soggybag/Wave-Folder/Wavefolder Yusynth - wiring.jpg

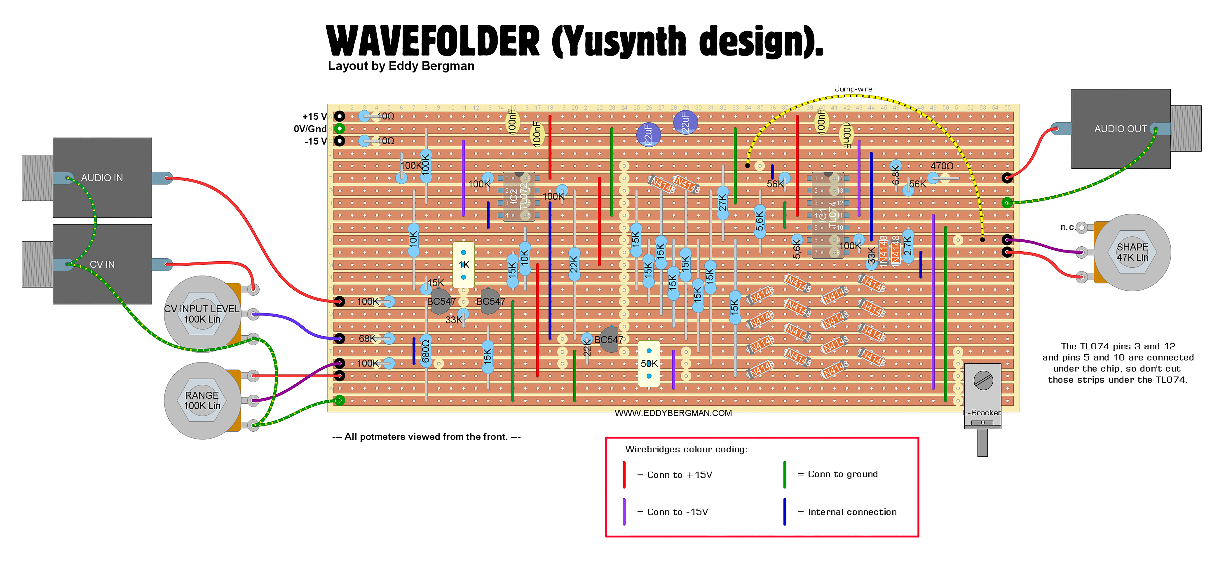
Wavefolder Yusynth - wiring.jpg
