soggybag/Wave-Folder/README.md

# Wave Folder (Eurorack 4HP)

YuSynth wavefolder reworked as a 4HP Eurorack module: BAV99 pairs, matched NPN VCA, split boards. KiCad project in `Wave_Folder/`, panel in `Front-Panel/`.

**Status:** PCB and fab files done; not ordered. YuSynth designs are shared for DIY use: ask before selling.

Product notes and ratings: `../Product Notes.md`, `../Project Status.xlsx`.
