soggybag/Wave-Folder/Wave Folder.png

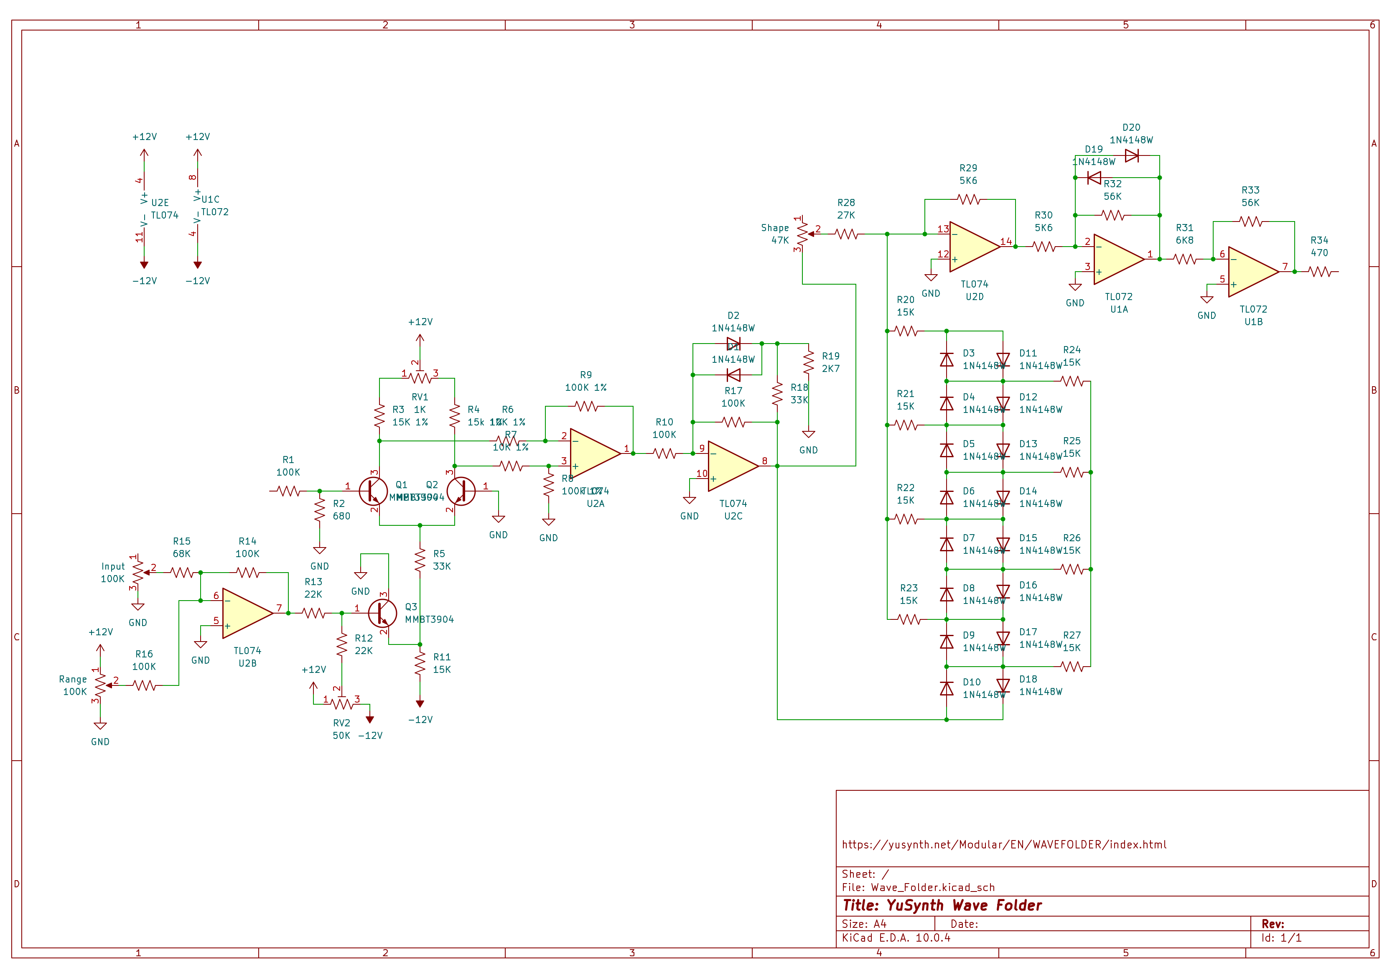
Wave Folder.png
