soggybag/Wave-Folder/Wavefolder Yusynth.jpg

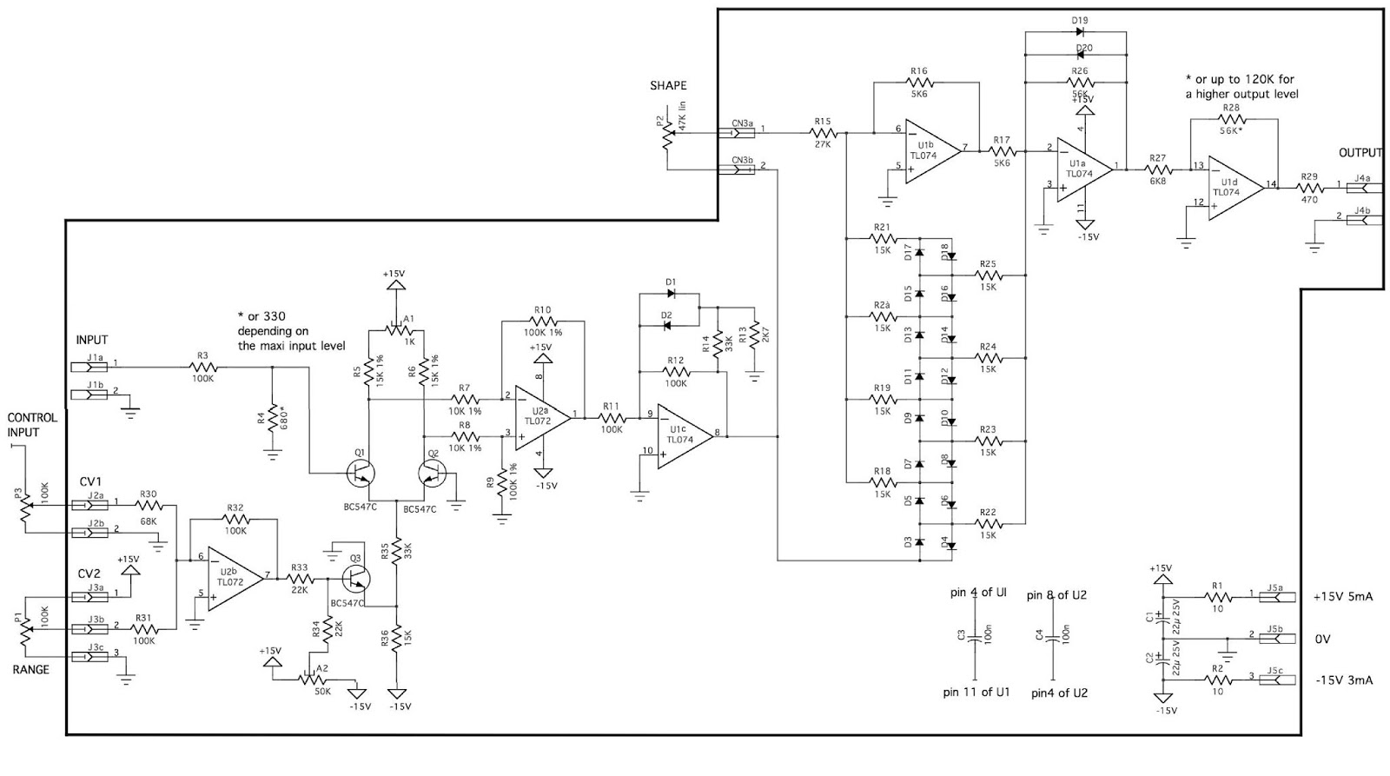
Wavefolder Yusynth.jpg
