soggybag/Wave-Folder/Wave_Folder/production/bom.csv

Designator | Footprint | Quantity | Value | LCSC Part #
C2, C3 | 0805 | 2 | 100 nF 50 V X7R | C49678
C6, C7 | 0805 | 2 | 10 µF 25 V X5R | C15850
D1, D10, D2, D3, D4, D5, D6, D7, D8, D9 | SOT-23 | 10 | BAV99 | C2500
D11, D12 | D_SMA | 2 | SS14 (40 V 1 A Schottky) | C2480
Q1 | SOT-363_SC-70-6 | 1 | DMMT3904W | C155305
Q2 | SOT-23 | 1 | MMBT3904 | C20526
R1, R10, R14, R16, R17, R8, R9 | 0805 | 7 | 100k | C149504
R11, R20, R21, R22, R23, R24, R25, R26, R27, R3, R4 | 0805 | 11 | 15k | C17475
R12, R13 | 0805 | 2 | 22k | C17560
R15 | 0805 | 1 | 68k | C17801
R18, R5 | 0805 | 2 | 33k | C17633
R19 | 0805 | 1 | 2k7 | C17530
R2 | 0805 | 1 | 680 | C17798
R28 | 0805 | 1 | 27k | C17593
R29, R30 | 0805 | 2 | 5k6 | C4382
R31 | 0805 | 1 | 6k8 | C17772
R32, R33 | 0805 | 2 | 56k | C17756
R34 | 0805 | 1 | 470 | C17710
R35, R36 | 0805 | 2 | 10 | C17415
R6, R7 | 0805 | 2 | 10k | C17414
U1 | SOIC-8_3.9x4.9mm_P1.27mm | 1 | TL072 | C6961
U2 | SOIC-14_3.9x8.7mm_P1.27mm | 1 | TL074 | C6963
