soggybag/Wave-Folder/Wave_Folder/Wave_Folder.kicad_pcb

## KiCad design Wave_Folder/Wave_Folder.kicad_pcb (2026-10-17)

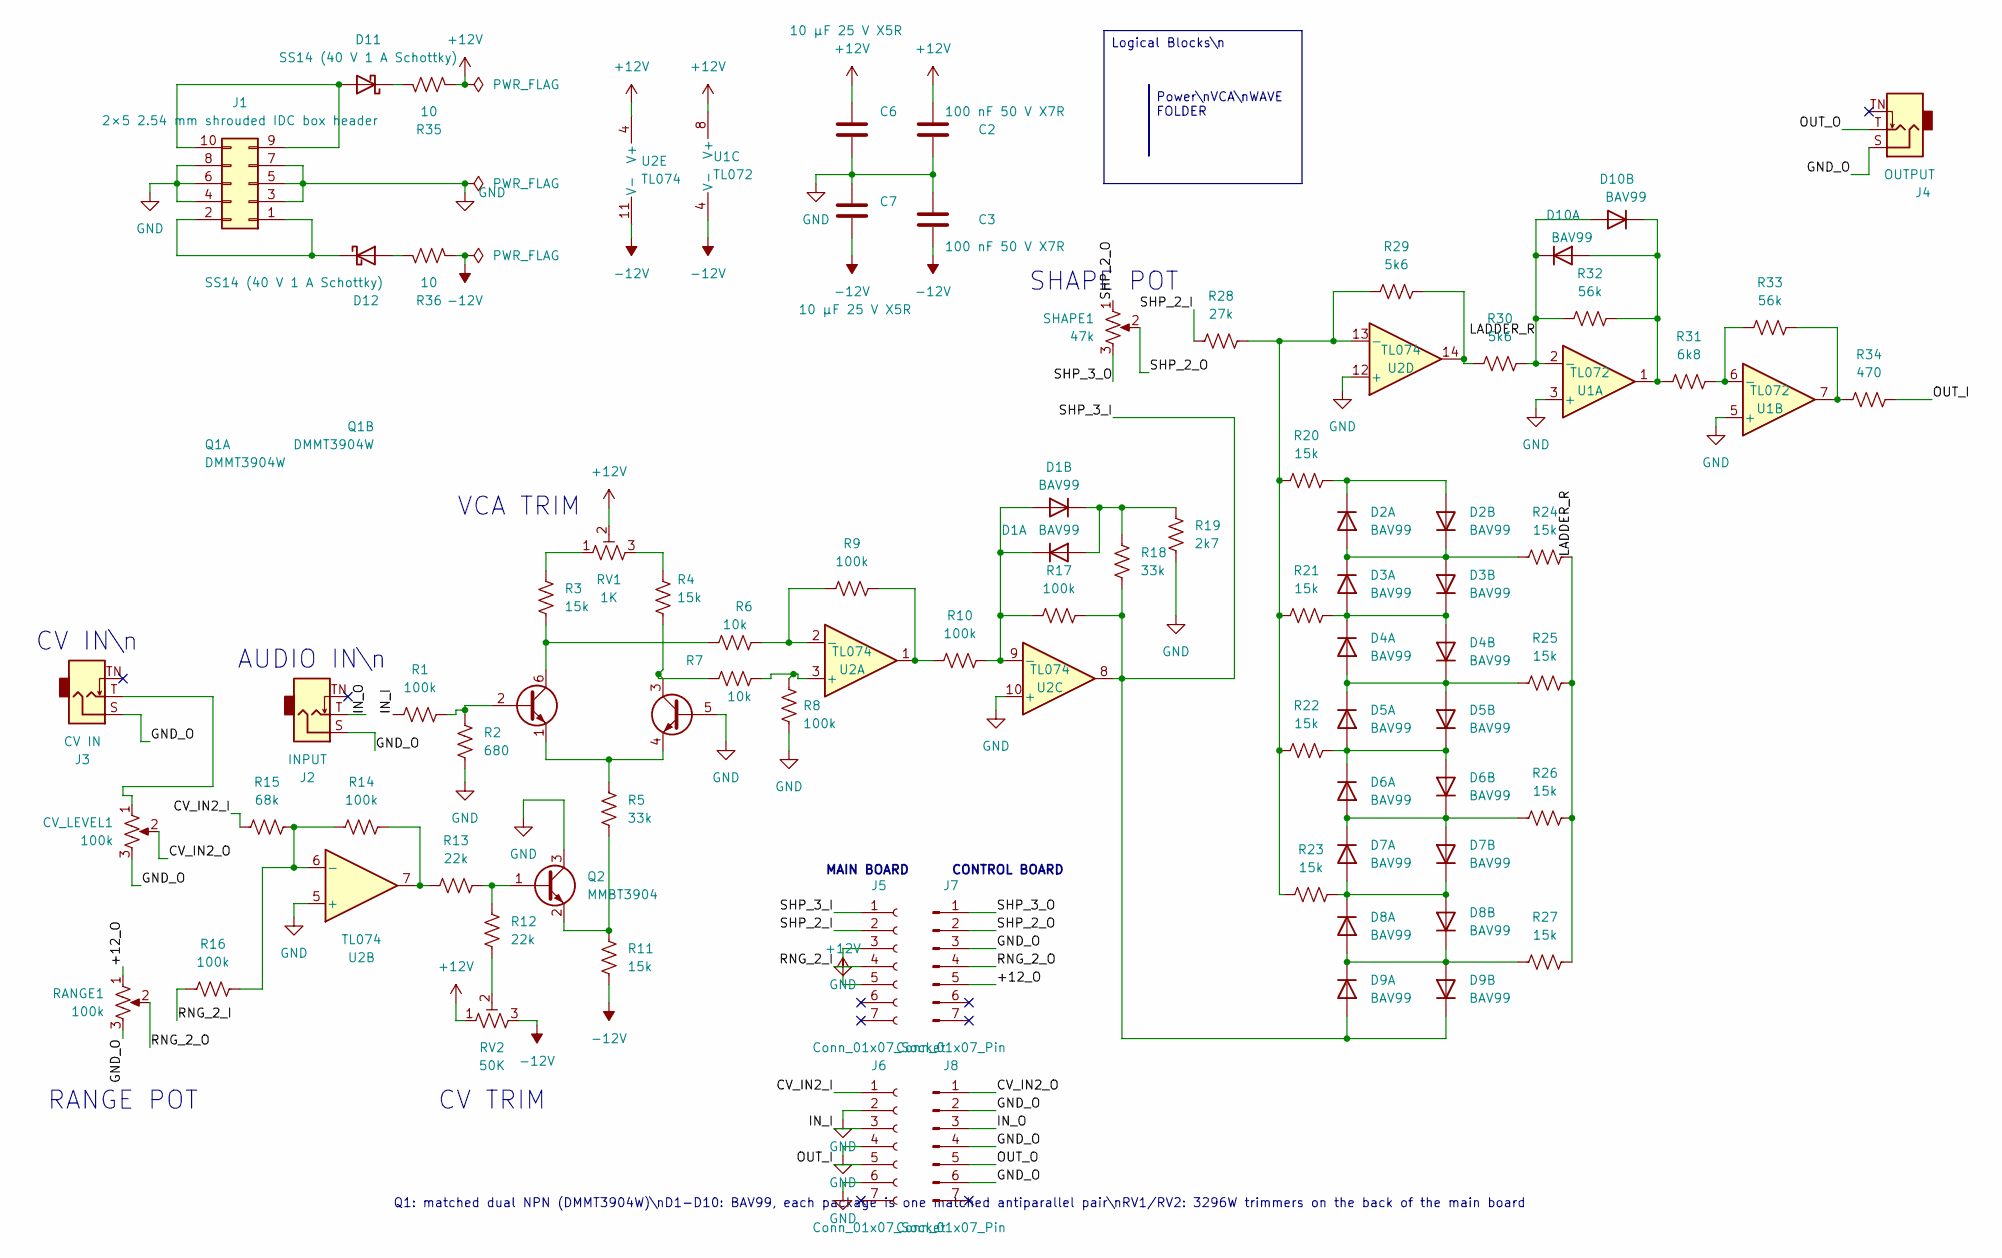
[picture p4: schematic Wave_Folder.kicad_sch, YuSynth Wave Folder]

Parts:
C2, C3: 100 nF 50 V X7R; C_0805_2012Metric; LCSC C49678
C6, C7: 10 µF 25 V X5R; C_0805_2012Metric; LCSC C15850
CV_LEVEL1: 100k; Potentiometer_Alpha_RD901F-40-00D_Single_Vertical
D1, D2, D3, D4, D5, D6, D7, D8, D9, D10: BAV99; SOT-23; LCSC C2500
D11, D12: SS14 (40 V 1 A Schottky); D_SMA; LCSC C2480
J1: 2×5 2.54 mm shrouded IDC box header; IDC-Header_2x05_P2.54mm_Vertical
J2: INPUT; Jack_3.5mm_QingPu_WQP-PJ398SM_Vertical_CircularHoles
J3: CV IN; Jack_3.5mm_QingPu_WQP-PJ398SM_Vertical_CircularHoles
J4: OUTPUT; Jack_3.5mm_QingPu_WQP-PJ398SM_Vertical_CircularHoles
J5, J6: Conn_01x07_Socket; PinSocket_1x07_P2.54mm_Vertical
J7, J8: Conn_01x07_Pin; PinHeader_1x07_P2.54mm_Vertical
Q1: DMMT3904W; SOT-363_SC-70-6; LCSC C155305
Q2: MMBT3904; SOT-23; LCSC C20526
R1, R8, R9, R10, R14, R16, R17: 100k; R_0805_2012Metric; LCSC C149504
R2: 680; R_0805_2012Metric; LCSC C17798
R3, R4, R11, R20, R21, R22, R23, R24, R25, R26, R27: 15k; R_0805_2012Metric; LCSC C17475
R5, R18: 33k; R_0805_2012Metric; LCSC C17633
R6, R7: 10k; R_0805_2012Metric; LCSC C17414
R12, R13: 22k; R_0805_2012Metric; LCSC C17560
R15: 68k; R_0805_2012Metric; LCSC C17801
R19: 2k7; R_0805_2012Metric; LCSC C17530
R28: 27k; R_0805_2012Metric; LCSC C17593
R29, R30: 5k6; R_0805_2012Metric; LCSC C4382
R31: 6k8; R_0805_2012Metric; LCSC C17772
R32, R33: 56k; R_0805_2012Metric; LCSC C17756
R34: 470; R_0805_2012Metric; LCSC C17710
R35, R36: 10; R_0805_2012Metric; LCSC C17415
RANGE1: 100k; Potentiometer_Alpha_RD901F-40-00D_Single_Vertical
RV1: 1K; Potentiometer_Bourns_3296W_Vertical
RV2: 50K; Potentiometer_Bourns_3296W_Vertical
SHAPE1: 47k; Potentiometer_Alpha_RD901F-40-00D_Single_Vertical
U1: TL072; SOIC-8_3.9x4.9mm_P1.27mm; LCSC C6961
U2: TL074; SOIC-14_3.9x8.7mm_P1.27mm; LCSC C6963

Connections:
+12V: C2.1, C6.1, J5.5, R35.1, RV1.2, RV2.1, U1.8 (V+), U2.4 (V+)
-12V: C3.2, C7.2, R11.2, R36.1, RV2.3, U1.4 (V-), U2.11 (V-)
/+12_O: J7.5, RANGE1.1
/CV_IN2_I: J6.1, R15.1
/CV_IN2_O: CV_LEVEL1.2, J8.1
/GND_O: CV_LEVEL1.3, J2.S, J3.S, J4.S, J7.3, J8.2, J8.4, J8.6, RANGE1.3
/IN_I: J6.3, R1.1
/IN_O: J2.T, J8.3
/LADDER_R: D10.3 (K), R24.2, R25.2, R26.2, R27.2, R30.2, R32.1, U1.2 (-)
/OUT_I: J6.5, R34.2
/OUT_O: J4.T, J8.5
/RNG_2_I: J5.4, R16.1
/RNG_2_O: J7.4, RANGE1.2
/SHP_2_I: J5.2, R28.1
/SHP_2_O: J7.2, SHAPE1.1, SHAPE1.2
/SHP_3_I: D9.1 (A), D9.2 (K), J5.1, R17.2, R18.2, U2.8
/SHP_3_O: J7.1, SHAPE1.3
GND: C2.2, C3.1, C6.2, C7.1, J1.3, J1.4, J1.5, J1.6, J1.7, J1.8, J5.3, J6.2, J6.4, J6.6, Q1.5 (B2), Q2.3 (C), R2.2, R8.2, R19.2, U1.3 (+), U1.5 (+), U2.5 (+), U2.10 (+), U2.12 (+)
unnamed: CV_LEVEL1.1, J3.T
unnamed: D1.1 (A), D1.2 (K), R18.1, R19.1
unnamed: D1.3 (K), R10.2, R17.1, U2.9 (-)
unnamed: D2.1 (A), D2.2 (K), D3.3 (K), R24.1
unnamed: D2.3 (K), R20.2
unnamed: D3.1 (A), D3.2 (K), D4.3 (K), R21.2
unnamed: D4.1 (A), D4.2 (K), D5.3 (K), R25.1
unnamed: D5.1 (A), D5.2 (K), D6.3 (K), R22.2
unnamed: D6.1 (A), D6.2 (K), D7.3 (K), R26.1
unnamed: D7.1 (A), D7.2 (K), D8.3 (K), R23.2
unnamed: D8.1 (A), D8.2 (K), D9.3 (K), R27.1
unnamed: D10.1 (A), D10.2 (K), R31.1, R32.2, U1.1
unnamed: D11.2 (A), J1.9, J1.10
unnamed: D11.1 (K), R35.2
unnamed: D12.2 (A), R36.2
unnamed: D12.1 (K), J1.1, J1.2
unnamed: Q1.2 (B1), R1.2, R2.1
unnamed: Q1.6 (C1), R3.2, R6.1
unnamed: Q1.1 (E1), Q1.4 (E2), R5.1
unnamed: Q1.3 (C2), R4.2, R7.1
unnamed: Q2.1 (B), R12.1, R13.2
unnamed: Q2.2 (E), R5.2, R11.1
unnamed: R3.1, RV1.1
unnamed: R4.1, RV1.3
unnamed: R9.2, R10.1, U2.1
unnamed: R12.2, RV2.2
unnamed: R13.1, R14.2, U2.7
unnamed: R29.2, R30.1, U2.14
unnamed: R33.2, R34.1, U1.7
unnamed: R31.2, R33.1, U1.6 (-)
unnamed: R7.2, R8.1, U2.3 (+)
unnamed: R6.2, R9.1, U2.2 (-)
unnamed: R14.1, R15.2, R16.2, U2.6 (-)
unnamed: R20.1, R21.1, R22.1, R23.1, R28.2, R29.1, U2.13 (-)

Notes on the sheet:
AUDIO IN\n
VCA TRIM
CV IN\n
RANGE POT
SHAPE POT
CV TRIM
Power\nVCA\nWAVE FOLDER
Logical Blocks\n
MAIN BOARD
CONTROL BOARD
Q1: matched dual NPN (DMMT3904W)\nD1-D10: BAV99, each package is one matched antiparallel pair\nRV1/RV2: 3296W trimmers on the back of the main board

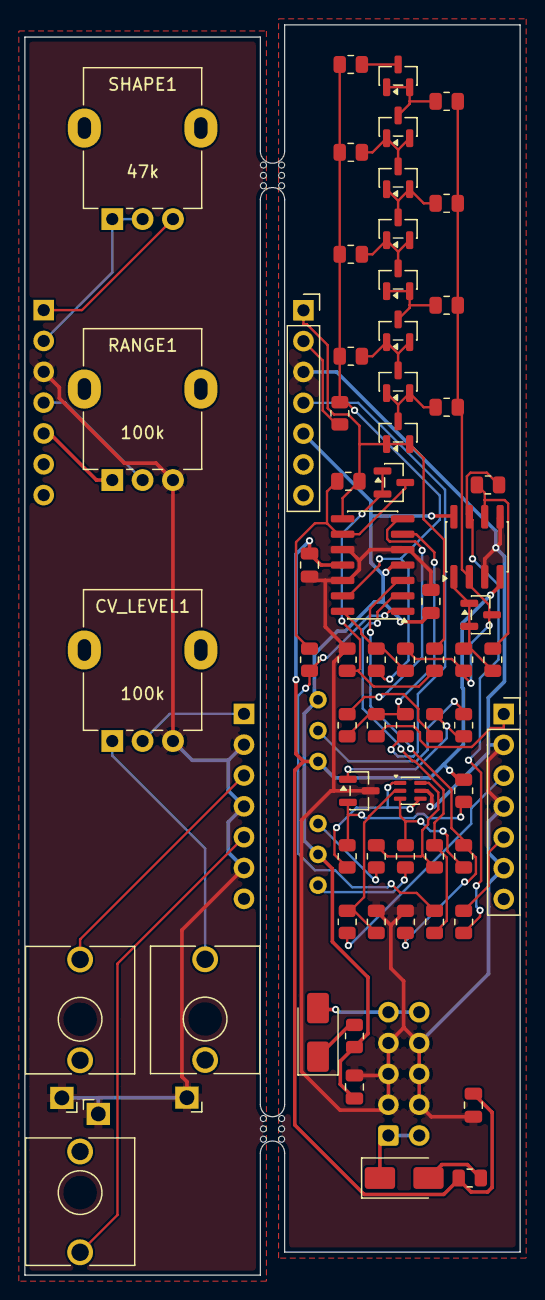
[picture p5: board Wave_Folder.kicad_pcb from above]

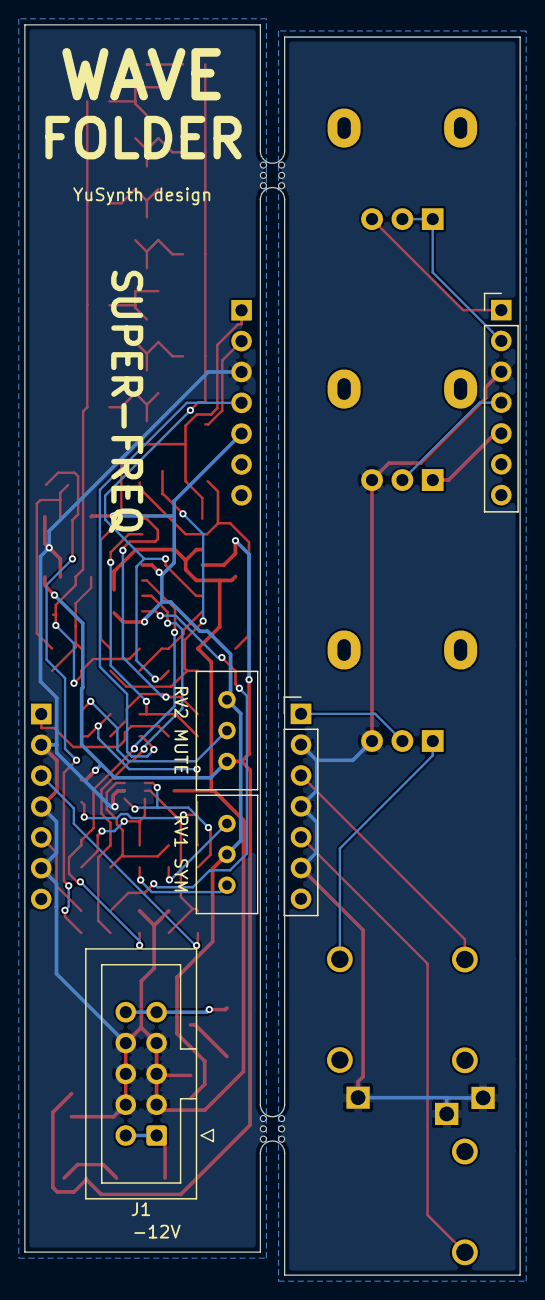
[picture p6: board Wave_Folder.kicad_pcb from below]

Board: 2 copper layers, 40.8 x 103.0 mm, 69 parts (5 on the bottom side), 52 nets.
